mikkosyrjasuo/UNIS-ionosonde/README.md

# UNIS-ionosonde
Hardware details including watchdog circuitry etc.
