mikkosyrjasuo/UNIS-ionosonde/KiCad/Ionosonde_watchdog/README.md

# The watchdog circuit for the ionosonde in Svalbard

A quick prototype was made from rather random components found at the bottoms of several drawers. The schematics are there for documentation purposes only. In short, do not trust any component names (except MAX693 and resistor+cap values)
