mikkosyrjasuo/UNIS-ionosonde/KiCad/Ionosonde_watchdog/Ionosonde_watchdog.pdf

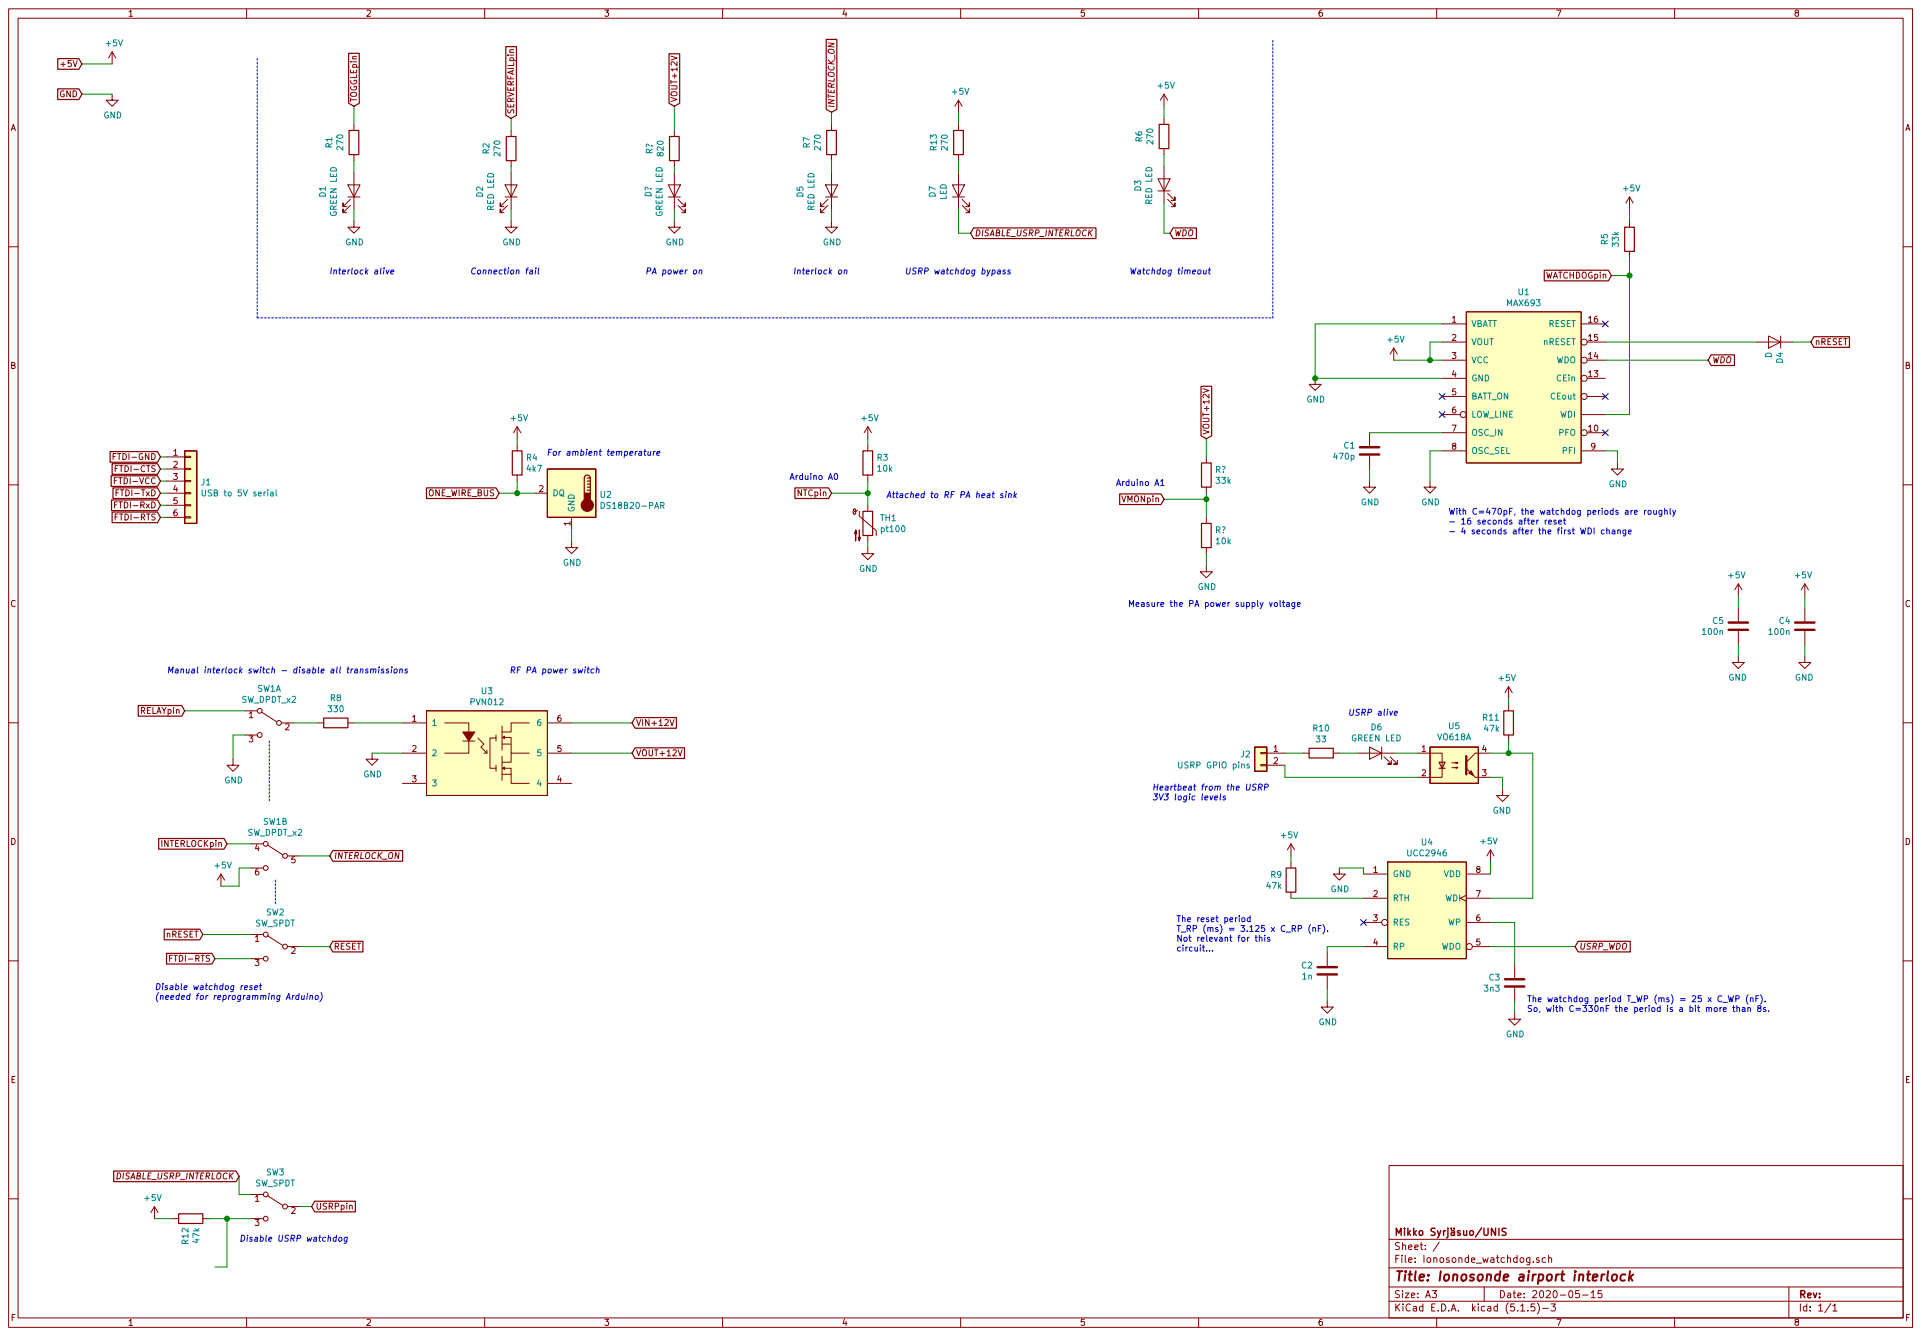
[picture p1: page 1]

33k GND R? 820 GND D? GREEN LED GND

File: Ionosonde_watchdog.sch Sheet: / Mikko Syrjäsuo/UNIS R13 270

- 16 seconds after reset - 4 seconds after the first WDI change

Measure the PA power supply voltage

So, with C=330nF the period is a bit more than 8s. USRP alive

T_RP (ms) = 3.125 x C_RP (nF). Not relevant for this

Disable watchdog reset
(needed for reprogramming Arduino)

The watchdog period T_WP (ms) = 25 x C_WP (nF).

Id: 1/1 Title: Ionosonde airport interlock
