mikkosyrjasuo/UNIS-ionosonde/KiCad/Ionosonde_watchdog/Ionosonde_watchdog_proto.pdf

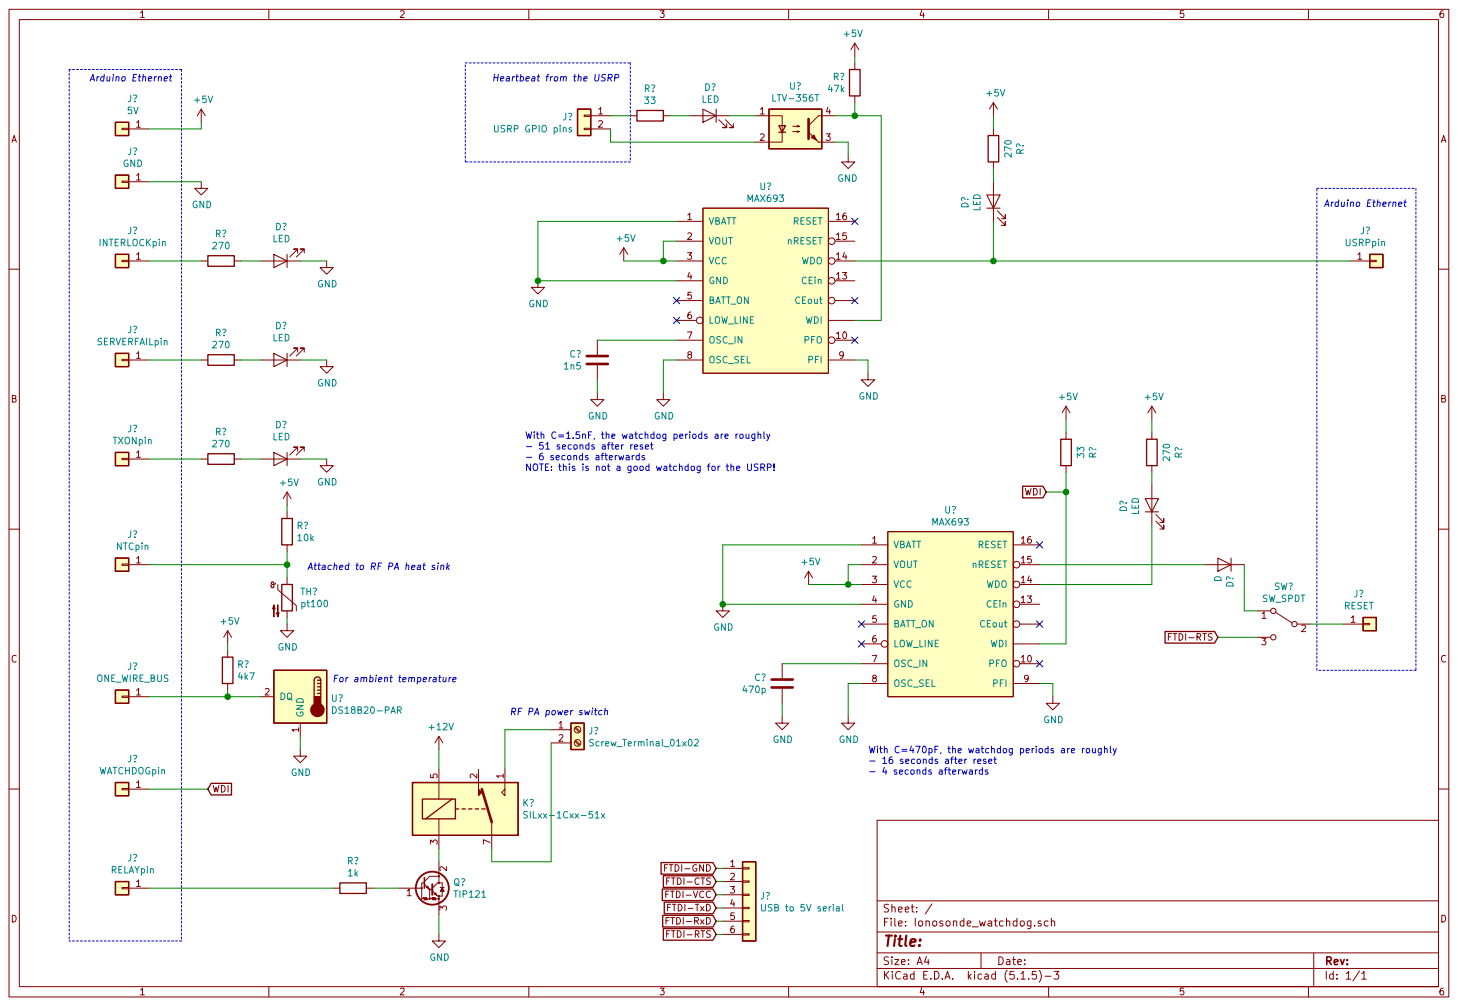
[picture p2: page 1]

Arduino Ethernet Heartbeat from the USRP With C=1.5nF, the watchdog periods are roughly

- 51 seconds after reset - 6 seconds afterwards NOTE: this is not a good watchdog for the USRP!

With C=470pF, the watchdog periods are roughly
- 16 seconds after reset - 4 seconds afterwards
