mikkosyrjasuo/UNIS-ionosonde/(commit log)

2020-05-09 Notes about serial ports in Linux/Raspberry
2020-05-09 Added DS18B20 and NTC temperature sensors
2020-05-11 First version
    [Ionosonde_watchdog.kicad_pcb, Ionosonde_watchdog.sch]
2020-05-12 Added pdf schematics
2020-05-15 New schematics
    [Ionosonde_watchdog.sch]
2020-05-20 Added ethernet timeouts, fixed USRP pin polarity
    [ionosonde-watchdog.ino]
2020-06-09 Added voltage monitoring
    [Ionosonde_watchdog.sch]
2020-10-07 Small corrections
    [Ionosonde_watchdog.sch]
